Elin310/VO2max/images/arduino v1.1/Myambiance2.PNG

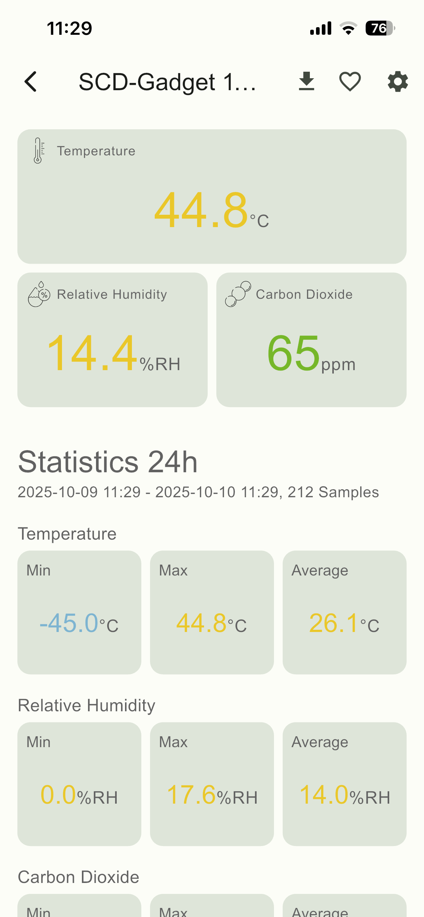
images/arduino v1.1/Myambiance2.PNG
