Elin310/VO2max/images/arduino v1.1/MyAmbience_1.PNG

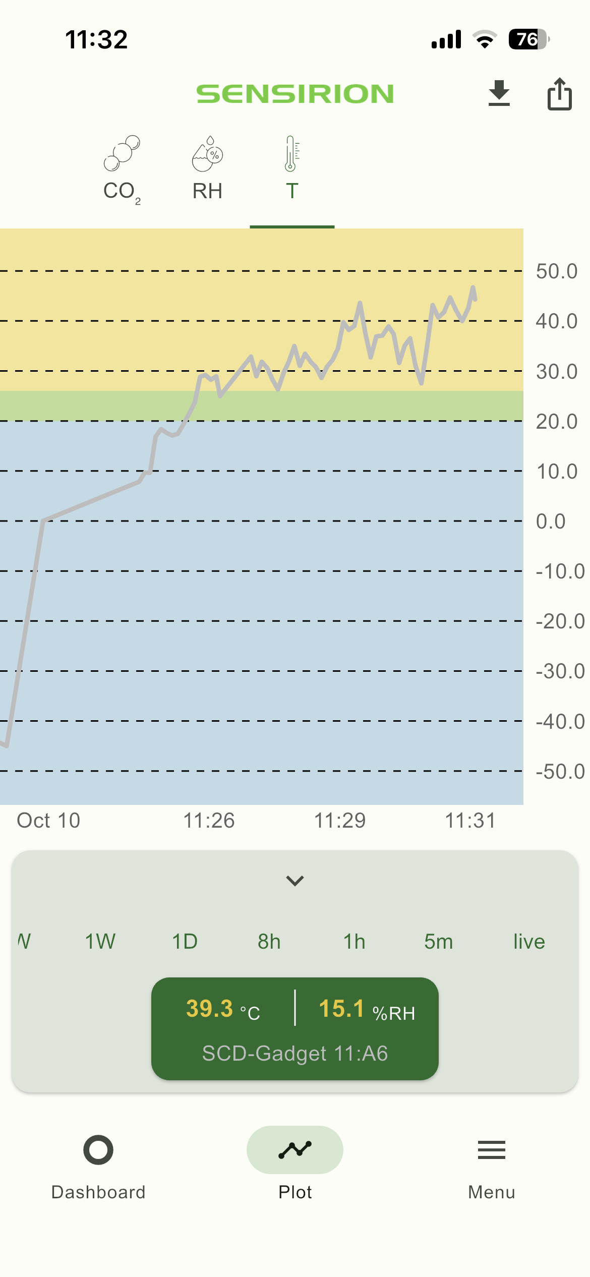
images/arduino v1.1/MyAmbience_1.PNG
