Elin310/VO2max/images/arduino v1.1/MyAmbience_3.PNG

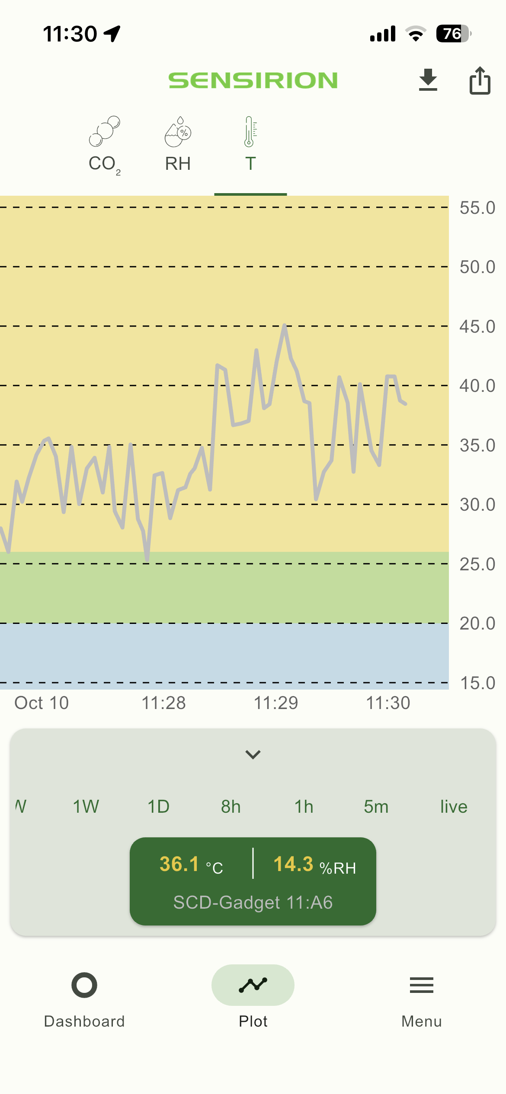
images/arduino v1.1/MyAmbience_3.PNG
