Elin310/VO2max/images/arduino v1.1/pressuresensor.JPG

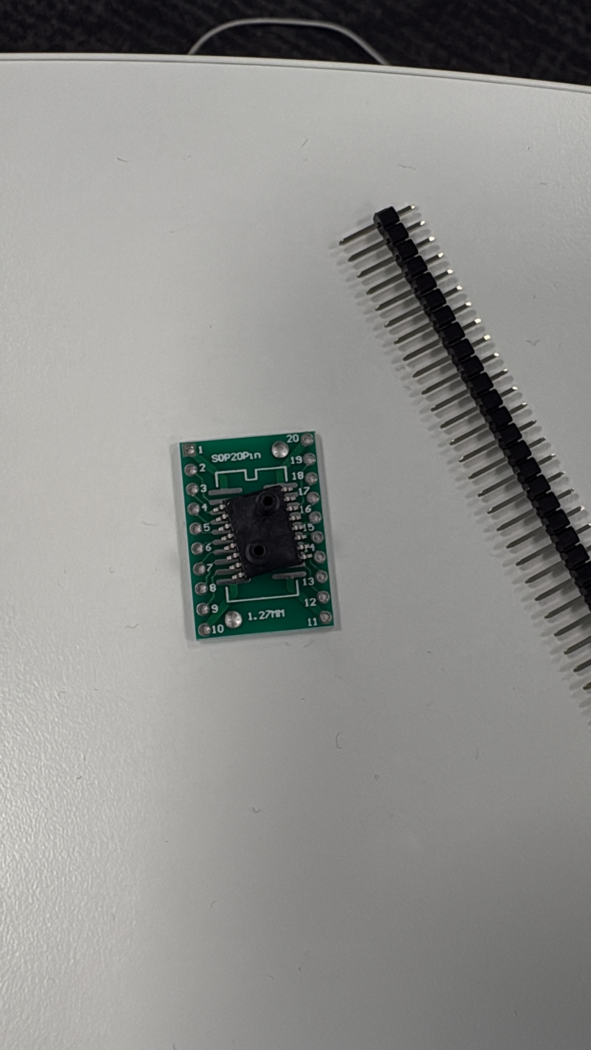
images/arduino v1.1/pressuresensor.JPG
