Elin310/VO2max/images/arduino v1.1/wiring2.jpg

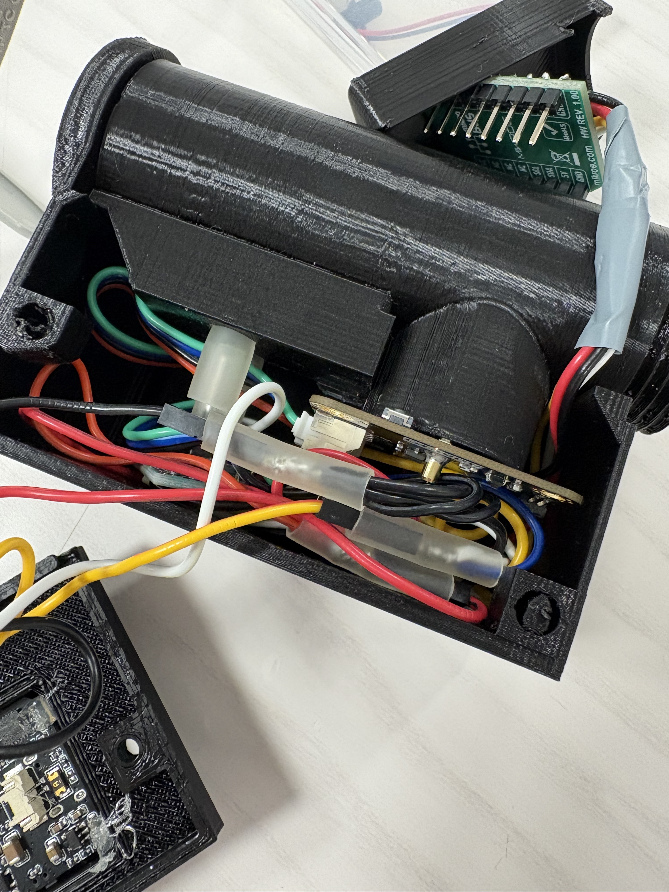
images/arduino v1.1/wiring2.jpg
