Elin310/VO2max/images/arduino v1.1/wiring3.jpg

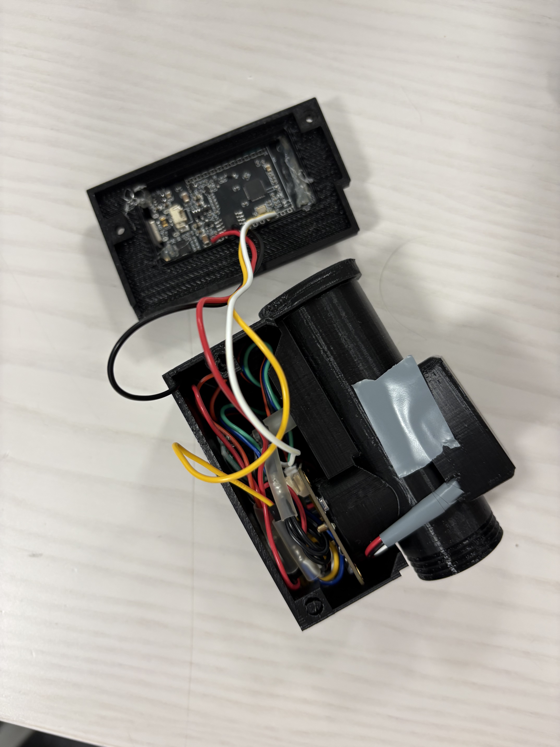
images/arduino v1.1/wiring3.jpg
