Elin310/VO2max/images/arduino v1.1/Wiring_image.jpg

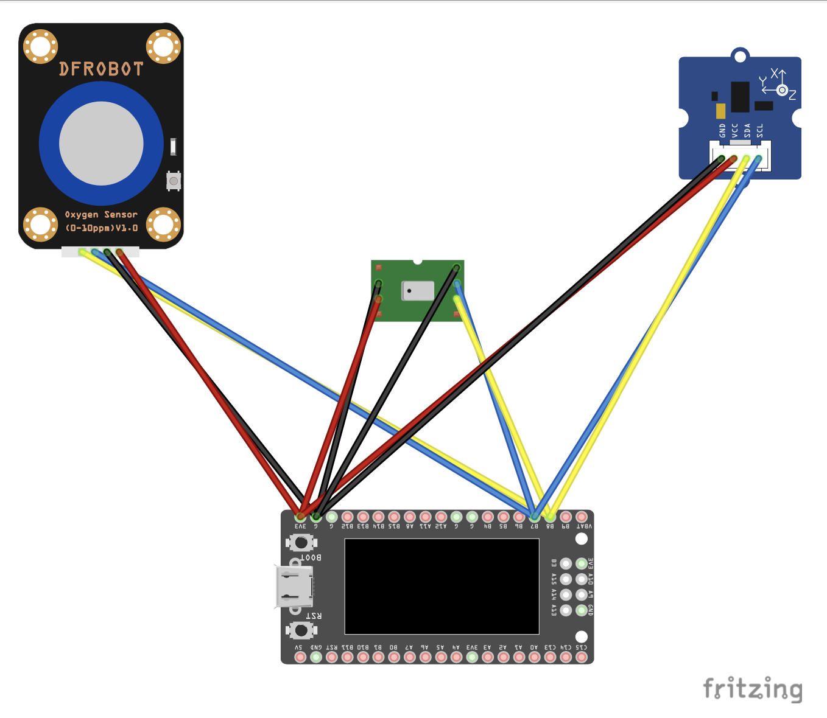
images/arduino v1.1/Wiring_image.jpg
