Elin310/VO2max/(commit log)

2025-10-09 Update BOM.md
    updated pressure sensor due to out of stock and with 2mm tube to match new diff pressure sensor
2025-10-10 Create README.md
    A file to describe the changes made to the original project for the Arduino 1.1 project
2025-10-10 Update README.md
    Current status updated
2025-10-10 Update BOM.md
    updated the CO2 sensor (EU)
2025-10-10 Update README.md
    Updated README file to reflect only arduino v1.1 project
